sydude/ESP32-P4-Display-Development-Daughterboard/docs/design-notes/email response from displayman on 9-15-2026.md

Dear Sy,

Thank you for your detailed inquiry.

Regarding the MIPI lane rate question, if the calculated lane rate exceeds your specification limits, you can lower the frame rate to fit your host design.

A strict 60 FPS is not mandatory—the module supports a flexible frame rate range between 46 Hz and 60 Hz, as long as the screen displays properly.

Attached please find a screenshot of our reference LCD timing configuration code for your engineering team's review.

Please feel free to let us know if you need any further assistance.

Best Regards

Anson.ho
DISPLAYMAN (SZ) TECH CO., LTD
Mobile / WhatsApp: +86 189 4831 4091
Tel: +86 755 3317 7071
Website: displayman.com

[See image attached to email in separate repo file]
