sydude/ESP32-P4-Display-Development-Daughterboard/docs/references.md

# References

This index records source documents and manufacturer links used by the project. Manufacturer and third-party PDFs are not stored in this repository unless deliberately approved.

## User-supplied project sources

| ID | Manufacturer / source | Document | Revision / identity | Repository status |
|---|---|---|---|---|
| S1 | Displayman (SZ) Technology Co., Ltd. | `KD068HDFID009-C009A` module datasheet | v1.0, 2024-11-25, 40 pages; SHA-256 `4c8394ac…03bcf` | External source; not committed |
| S2 | Displayman | `KD068HDFID009 -2LANE.txt` initialization file | SHA-256 `81ec9ab8…e6872c` | External source; not committed |
| S3 | Waveshare | `ESP32-P4-NANO-schematic.pdf` | PDF created 2024-10-25; SHA-256 `1e57b31f…10de1` | Original manufacturer PDF committed under `hardware/mechanical/vendor/Waveshare/ESP32-P4-NANO/`; authoritative electrical cross-check |
| S7 | Displayman, Anson Ho | Email reporting Displayman engineering confirmation that S2, including `RSOX(600)`, is correct for exact module | Received 2026-09-13 | External correspondence; summarized in PRD v0.2 |
| S8 | Displayman, Anson Ho | Detailed engineering response covering IOVCC, sequence, DSI, backlight, mapping, FPCs, and GT9271 | Received 2026-09-14; SHA-256 `76a9e53303412ff29189debf72a1f4c5dcf495e249f0ce86e32092063407ed4d` | User deliberately committed [email-chain PDF](design-notes/Re-%20Displayman%20%7C%20Datasheet%20%26%20Evaluation%20Units%20for%20KD068HDFID009-C009A.pdf); analyzed in PRD v0.3 |
| S9 | Displayman, Anson Ho | Follow-up email and reference LCD timing screenshot | Received 2026-09-15; email SHA-256 `8823097df6d8f23fd516d2b6e0f963860ce33b882156e1e74eb6324d2f1189f4`; screenshot SHA-256 `0e07dbbabf7c044b3f3cbf885d786e36a1ac6d44cc7af4ac6fe7aa517a8977d3` | User deliberately committed [email text](design-notes/email%20response%20from%20displayman%20on%209-15-2026.md) and [timing screenshot](design-notes/email%20response%20from%20displayman%20on%209-15-2026%20%5BIMAGE%5D.jpg) in `e98d2188f5f2b2ff797b6d45c06f2300e67c91f1`; analyzed in PRD v0.5 |
| S10 | Waveshare | ESP32-P4-NANO Wiki GPIO/pinout chart, `ESP32-P4-NANO-details_inter.jpg` | SHA-256 `271259f8…b8f5d9` | Original manufacturer chart committed beside S3; primary source for physical P1/P2 pin positions and GPIO names |
| S11 | Waveshare | ESP32-P4-NANO board image, `esp32-p4-nano.jpg` | SHA-256 `33af2c47…25f76` | Original Wiki image committed for visual orientation/corroboration only; not a precision dimensional source |

Abbreviated hashes match `docs/PRD.md`. Full hashes should be retained in controlled project records if the source package is deliberately archived.

## Platform and board documentation

Checked through 2026-09-21.

| Manufacturer | Document | Revision / date | Source |
|---|---|---|---|
| Espressif Systems | ESP32-P4 Series Datasheet | v0.7, 2026-07-14 | [Manufacturer documentation](https://documentation.espressif.com/esp32-p4_datasheet_en.html) |
| Espressif Systems | ESP32-P4 Hardware Design Guidelines | v1.9, 2026-07-21 | [Manufacturer PDF](https://documentation.espressif.com/esp-hardware-design-guidelines/en/latest/esp32p4/esp-hardware-design-guidelines-en-master-esp32p4.pdf) |
| Espressif Systems | ESP-IDF MIPI DSI LCD API | Current online documentation | [Manufacturer documentation](https://docs.espressif.com/projects/esp-idf/en/stable/esp32p4/api-reference/peripherals/lcd/dsi_lcd.html) |
| Waveshare | ESP32-P4-NANO product documentation | Current online documentation; S10 controls physical header mapping, S3 is the electrical cross-check, and the original PDF/DXF/STEP control dimensions | [Manufacturer documentation](https://www.waveshare.com/wiki/ESP32-P4-NANO) |

## Display-module corroboration and evidence limits

Checked 2026-09-15. These public listings are secondary to the exact-module datasheet, initialization file, and direct Displayman correspondence. They support product identity/family plausibility only and do not establish a GC9703C HS lane-rate limit.

| Evidence class | Source | Supported observation | Explicit limitation |
|---|---|---|---|
| Manufacturer public listing | Displayman, KD068HDFID009-C009A | Exact module is listed as 480 × 1280, two-lane MIPI display, I²C touch, GT9271 | Does not publish D-PHY HS operating rate or controller maximum; [manufacturer page](https://displayman.com/bar-type-tft-lcd-displays/) |
| Third-party exact-family listing | Startek/TFT-TFT, KD068HDFID009 | Base module is listed as GC9703C, 480 × 1280, two-lane MIPI, 40-pin, 6S4P/19.2 V/240 mA | Not a substitute for exact C009A controlled documentation; [product page](https://en.tft-tft.com/product/1658-KD068HDFID009-6.8-inch-480x1280-2-Lane-MIPI-interface-GC9703C-Bar-Type-TFT-high-brightness-IPS-LCD-Module.html) |
| Third-party sibling-module listing | Startek/TFT-TFT, KD068HDFID020 | Closely related 480 × 1280 / 60.19 × 160.51 mm GC9703C platform is offered with 3/4-lane MIPI | Sibling evidence only; cannot prove C009A rate capability; [product page](https://www.tft-tft.com/product/detail?id=899) |

No authoritative independent GC9703C datasheet or manufacturer source substantiating the previously stated 500 Mb/s/lane maximum was located in this review. Accordingly, 500 Mb/s/lane is recorded as an unverified claim, not as a controller specification; absence of corroboration is not proof of a higher limit.

## Power, sequencing, and interface components

Checked through 2026-09-19. Status is the manufacturer product-page status where shown. `docs/PRD.md` remains controlling; the populated selections and calculations are recorded in `docs/design-notes/schematic-calculations.md`.

| Manufacturer | Part number / family | Function | Status / document | Source |
|---|---|---|---|---|
| Texas Instruments | `LM76003RNPR` | 24 V to 5 V buck | ACTIVE; datasheet Rev. A | [LM76003](https://www.ti.com/product/LM76003) |
| Texas Instruments | `TLV75533PDBVR`, `TLV75528PDBVR`, `TLV75518PDBVR` | Touch 3.3 V / VCI 2.8 V / IOVCC 1.8 V LDOs | ACTIVE/production; datasheet Rev. D | [TLV755P](https://www.ti.com/product/TLV755P) |
| Texas Instruments | `TPS22919DCKR` | VCI load switch | ACTIVE; datasheet Rev. B | [TPS22919](https://www.ti.com/product/TPS22919) |
| Texas Instruments | `LM3880MF-1AA/NOPB` | Three-stage display sequencer | ACTIVE/production; datasheet Rev. M; exact `-1AA` gives 1→2→3 startup and 3→2→1 shutdown with 10 ms nominal stages | [LM3880](https://www.ti.com/product/LM3880), [datasheet](https://www.ti.com/lit/ds/symlink/lm3880.pdf) |
| Texas Instruments | `TPS3808G01DBVR` | Power-fail supervisor | ACTIVE/production; datasheet Rev. N; pinout, ±2% adjustable threshold, SENSE current and 1–10 nF bypass recommendation audited | [TPS3808](https://www.ti.com/product/TPS3808), [datasheet](https://www.ti.com/lit/ds/symlink/tps3808.pdf) |
| Texas Instruments | `SN74LVC1G07DBVR` | Open-drain reset buffer with Ioff | ACTIVE; datasheet Rev. AG | [SN74LVC1G07](https://www.ti.com/product/SN74LVC1G07) |
| Texas Instruments | `SN74LVC1G11DCKR` | Three-input hardware backlight-enable gate | ACTIVE; partial-power-down/Ioff behavior | [SN74LVC1G11](https://www.ti.com/product/SN74LVC1G11) |
| Texas Instruments | `PCA9306DCTR` | Original I2C translator candidate | ACTIVE; superseded because it does not isolate INT/RESET | [PCA9306](https://www.ti.com/product/PCA9306) |
| Texas Instruments | `TMUX1574DYYR` / `TMUX1574PWR` | Recommended four-channel powered-off-protected touch switch | ACTIVE; datasheet Rev. C | [TMUX1574](https://www.ti.com/product/TMUX1574) |
| Texas Instruments | `TPD6E05U06RVZR` | Six-channel MIPI ESD | ACTIVE; TPDxE05U06 family | [TPD6E05U06](https://www.ti.com/product/TPD6E05U06) |
| Texas Instruments | `TPD4E05U06DQAR` | Four-channel touch ESD | ACTIVE; TPDxE05U06 family | [TPD4E05U06](https://www.ti.com/product/TPD4E05U06) |
| Texas Instruments | `TPS92511DDA` | Original buck backlight candidate | ACTIVE; superseded as baseline because full-temperature current spread is wider than project ±5% target | [TPS92511](https://www.ti.com/product/TPS92511) |
| Texas Instruments | `TPS922053DYYR` | Preferred 240 mA buck backlight driver | ACTIVE/production; datasheet Rev. B; 4.5–65 V, external 200 mV current sense, 100 ns minimum off-time, fast/hybrid PWM | [TPS922053](https://www.ti.com/product/TPS922053), [datasheet](https://www.ti.com/lit/ds/symlink/tps922053.pdf) |
| Vishay | `IHLP6767GZER680M11` | Selected 68 µH backlight inductor | IHLP-6767GZ-11 commercial low-DCR series; 6.1 A heat-rated and 4.5 A typical saturation current; manufacturer product page/datasheet checked 2026-09-16 | [Manufacturer product page](https://www.vishay.com/en/product/34282/) |
| Vishay | `SS2H10-E3/52T`, `SS34-E3/57T`, `BAT46W-E3-08` | Backlight catch diode, hold-up diode, and LM5176 bootstrap diodes | Current manufacturer families; 100 V bootstrap/catch selections preserve voltage margin | [SS2H10](https://www.vishay.com/en/product/88961/), [SS34](https://www.vishay.com/en/product/88751/), [BAT46W](https://www.vishay.com/en/product/85662/) |
| Murata | `BLM18KG601SN1D` | Backlight-anode EMI bead | 0603, 600 Ω at 100 MHz, 1 A class; headroom/temperature to be verified on prototype | [Manufacturer page](https://www.murata.com/en-us/products/productdetail?partno=BLM18KG601SN1%23) |
| KEMET | `C0603C823K3RACTU` | LM74800 82 nF/25 V/X7R HGATE dV/dt capacitor | Current 0603 X7R catalog part; selected in place of an obsolete Murata suffix found during the audit | [KEMET X7R SMD family datasheet](https://content.kemet.com/datasheets/KEM_C1002_X7R_SMD.pdf) |
| Panasonic | `ERJ-3EKF1002V` | LM74800 10 kΩ/1% HGATE series resistor | Current general-purpose 0603 precision thick-film part | [Manufacturer part page](https://industrial.panasonic.com/ww/products/pt/general-purpose-chip-resistors/models/ERJ3EKF1002V) |
| Murata | `GRM1885C1H102JA01D` | TPS3808 1 nF/50 V/C0G SENSE bypass | Current 0603 C0G catalog part | [Manufacturer product detail](https://pim.murata.com/en-us/pim/details/?partNum=GRM1885C1H102JA01D) |
| Analog Devices | `LT8391A` | Four-switch buck-boost LED contingency | Recommended for new designs; datasheet Rev. A; use only if completed buck headroom validation fails | [Product page](https://www.analog.com/en/products/lt8391a.html), [datasheet](https://www.analog.com/media/en/technical-documentation/data-sheets/lt8391a.pdf) |

## Nominal-12 V input, protection, and conversion components

Checked through 2026-09-16. Automotive/AEC qualification of individual parts does not qualify the assembled evaluation board to ISO 7637 or ISO 16750.

| Manufacturer | Part number / family | Function | Status / validation note | Source |
|---|---|---|---|---|
| Texas Instruments | `LM74800QDRRRQ1` / LM7480-Q1 | Vehicle reverse-polarity, reverse-current, inrush, and overvoltage control with back-to-back N-FETs | ACTIVE; AEC-Q100; 3–65 V, −65 V reverse input, WSON-12; datasheet Rev. C | [Product page](https://www.ti.com/product/LM7480-Q1), [datasheet](https://www.ti.com/lit/ds/symlink/lm7480-q1.pdf) |
| Texas Instruments | `LM5176QPWPRQ1` | 12 V vehicle to nominal-24 V four-switch synchronous buck-boost controller | ACTIVE; AEC-Q100; 4.2–55 V operating, 60 V maximum, HTSSOP-28; datasheet Rev. B | [Product page](https://www.ti.com/product/LM5176-Q1), [datasheet](https://www.ti.com/lit/ds/symlink/lm5176-q1.pdf) |
| Texas Instruments | `LM51772-Q1` | Newer four-switch comparison candidate | ACTIVE; 55 V, optional I²C, VQFN-40; not selected because its added complexity is unnecessary for a fixed 24 V rail | [Product page](https://www.ti.com/product/LM51772-Q1) |
| Texas Instruments | `CSD19531Q5A` | 100 V N-MOSFET for input protection and four-switch conversion | ACTIVE; 6.4 mΩ max at 10 V, 37 nC typical Qg, 5 × 6 mm SON; SOA checked for LM74800 ramp | [Product page](https://www.ti.com/product/CSD19531Q5A), [datasheet](https://www.ti.com/lit/ds/symlink/csd19531q5a.pdf) |
| Texas Instruments | `TPS259470ARPWR` / TPS25947 | Nano 5 V current limiting, inrush control, and true reverse-current blocking | ACTIVE; 2.7–23 V, 5.5 A, 28 mΩ typical; datasheet Rev. C, May 2026 | [Product page](https://www.ti.com/product/TPS25947), [datasheet](https://www.ti.com/lit/ds/symlink/tps25947.pdf) |
| Bourns | `SM8S24CA-Q` | Vehicle high-energy bidirectional TVS | Automotive/AEC-Q101 series; 24 V standoff, 38.9 V clamp class, 6.6 kW, DO-218; package and recommended land pattern used for project footprint | [Manufacturer datasheet/drawing](https://www.bourns.com/docs/product-datasheets/sm8s-q.pdf) |
| Coilcraft | `XAL7070-153MEC`, `XAL7070-103MEC` | Selected 15 µH LM5176 and 10 µH LM76003 inductors | Current shielded molded series; selected values and current ratings checked in the manufacturer table | [Manufacturer series page](https://www.coilcraft.com/en-us/products/power/shielded-inductors/molded-inductor/xal/xal7070/) |
| Bourns | `SRP1038A-2R2M` | Vehicle input-filter inductor | Shielded AEC-Q200 SRP1038A family; 2.2 µH, 8 A class; mechanical dimensions used for the local model | [Manufacturer product page](https://www.bourns.com/products/magnetic-products/power-inductors-smd-high-current-shielded/product/SRP1038A), [datasheet](https://www.bourns.com/docs/product-datasheets/srp1038a.pdf) |
| Molex | `43045-0218` / `43025-0200` | Selected keyed vehicle-evaluation connector pair | Micro-Fit 3.0, two circuits; vertical SMT board header with mating receptacle; not sealed/automotive-qualified; footprint checked against sales drawing | [Header](https://www.molex.com/en-us/products/part-detail/430450218), [housing](https://www.molex.com/en-us/products/part-detail/430250200), [drawing](https://www.molex.com/content/dam/molex/molex-dot-com/products/automated/en-us/salesdrawingpdf/430/43045/430450218_sd.pdf), [manufacturer STEP archive](https://www.molex.com/content/dam/molex/molex-dot-com/products/automated/en-us/3dcadmodels/430/43045/430450218_stp.zip) |
| Littelfuse / Keystone | `0297005.WXNV` / `3568` | Selected serviceable vehicle-branch fuse and PCB holder | 5 A MINI blade fuse in a through-hole PCB holder | [Littelfuse 297 series](https://www.littelfuse.com/products/fuses-overcurrent-protection/fuses/automotive-passenger-car/blade-fuses/297), [Keystone 3568](https://www.keyelco.com/product.cfm/product_id/14138) |

## Connectors and cables

Checked through 2026-09-21.

| Manufacturer | Part number | Function | Documented configuration | Source |
|---|---|---|---|---|
| Molex | `505110-4096` | Panel LCD connector | 40 position, 0.50 mm, bottom contact, front flip, 1.90 mm height; project footprint and official manufacturer STEP checked against sales drawing | [Manufacturer page](https://www.molex.com/en-us/products/part-detail/5051104096), [drawing](https://www.molex.com/content/dam/molex/molex-dot-com/products/automated/en-us/salesdrawingpdf/505/505110/5051104096_sd.pdf), [manufacturer STEP archive](https://www.molex.com/content/dam/molex/molex-dot-com/products/automated/en-us/3dcadmodels/505/505110/5051104096_stp.zip) |
| Molex | `0150200429` | Conditional panel LCD extension candidate | 40 circuit, 0.50 mm, type A same-side contacts, 76 mm; not a direct mate between J702 and a bare panel flex tail | [Manufacturer page](https://www.molex.com/en-us/products/part-detail/150200429) |
| Molex | `0150200431` | Conditional panel LCD extension candidate | 40 circuit, 0.50 mm, type A same-side contacts, 102 mm; not a direct mate between J702 and a bare panel flex tail | [Manufacturer page](https://www.molex.com/en-us/products/part-detail/150200431) |
| Amphenol Communications Solutions | `SFW15R-2STE1LF` | Nano DSI connector candidate | ACTIVE; 15 position, 1.00 mm, top contact, side-entry SMT ZIF; project footprint and official manufacturer STEP checked against drawing 10172241 Rev. A | [Manufacturer page](https://www.amphenol-cs.com/product/sfw15r2ste1lf.html), [drawing](https://cdn.amphenol-cs.com/media/wysiwyg/files/drawing/10172241.pdf), [manufacturer STEP archive](https://cdn.amphenol-cs.com/media/wysiwyg/files/3d/ssfw15r_2_4stlf.zip) |
| Hirose Electric | `FH12-8S-0.5SH(55)` | Touch connector candidate | 8 position, 0.50 mm, bottom contact, front ZIF, 2.0 mm height | [Manufacturer page](https://www.hirose.com/product/p/CL0586-0744-5-55) |
| Samtec | `SSQ-113-01-G-D` | Selected Nano P1/P2 stack sockets | 2 × 13, 2.54 mm pitch and row spacing, 8.51 mm body, 2.64 mm tails, 3.68–6.35 mm insertion range for 0.64 mm-square posts. Bottom-mounted on the daughterboard; nominal facing-PCB separation is 11.01 mm because USB-A/RJ45 are cleared by local cutouts. | [Exact product](https://www.samtec.com/products/ssq-113-01-g-d), [manufacturer SSQ drawing Rev. BH](https://suddendocs.samtec.com/prints/ssq-1xx-xx-xxx-x-xx-xxx-xx-x-mkt.pdf), [SSQ family](https://www.samtec.com/products/ssq) |
| Waveshare | ESP32-P4-NANO mechanical PDF/DXF/STEP dated 2026-03-31 | Nano outline, mounting holes, headers, component envelopes and stacking reference | Original files preserved under `hardware/mechanical/vendor/Waveshare/ESP32-P4-NANO/`; [manufacturer resources](https://docs.waveshare.com/ESP32-P4-NANO/Resources-And-Documents); validation in `docs/design-notes/mechanical-interface-verification.md` |

Manufacturer electrical and mechanical documents control the design. Distributor availability is a procurement snapshot and must be rechecked before schematic freeze, prototype purchasing, and assembly release.

## Package, footprint and model sources

Checked through 2026-09-20 for the final project-local footprint audit. These links supplement the component electrical sources above; manufacturer package drawings remain controlling. Project-local simplified models reproduce the verified mechanical envelope and board interface where an exact redistributable model was unavailable. Detailed dimensions, intentional land-pattern departures, corrections and physical-verification boundaries are recorded in `docs/design-notes/project-local-footprint-verification.md`.

| Manufacturer / source | Package or part | Use | Source |
|---|---|---|---|
| Texas Instruments | DRR0012E (4224874 C11), PWP0028V (4230409 A01), RNP0030B (4222784 B09), RPW0010A (4225183 A08) and DYY0014A (4224643 D07) | Project-local IC footprints/models independently checked against the current package and stencil drawings included in the selected-device datasheets | [TI package search](https://www.ti.com/packaging/docs/searchtipackages.tsp) and the selected-device datasheets linked above |
| Nichicon | `UHW1A682MHD` | Exact C601 selection; 6800 µF, 10 V, 16 mm × 25 mm body, 7.5 mm lead spacing | [Manufacturer UHW series page](https://www.nichicon.co.jp/english/products/aluminum_electrolytic_capacitors/uhw/) |
| KiCad | KiCad 10 standard footprint and 3D-model libraries | Standard passives, headers/sockets, touch FFC, fuse holder and common packages; four local copies retain standard land geometry while repairing absent model linkage | [Official KiCad libraries](https://gitlab.com/kicad/libraries) |

Official STEP files committed for Amphenol SFW15R-2STE1LF and Molex 505110-4096 were taken from the linked manufacturer archives. The Molex 43045-0218 model endpoint did not provide a usable archive during this pass, so the committed simplified Micro-Fit model follows the manufacturer sales drawing and verified footprint envelope; this limitation is recorded rather than presenting it as an official model.
