sydude/ESP32-P4-Display-Development-Daughterboard/docs/design-notes/email response from displayman on 9-15-2026 [IMAGE].jpg

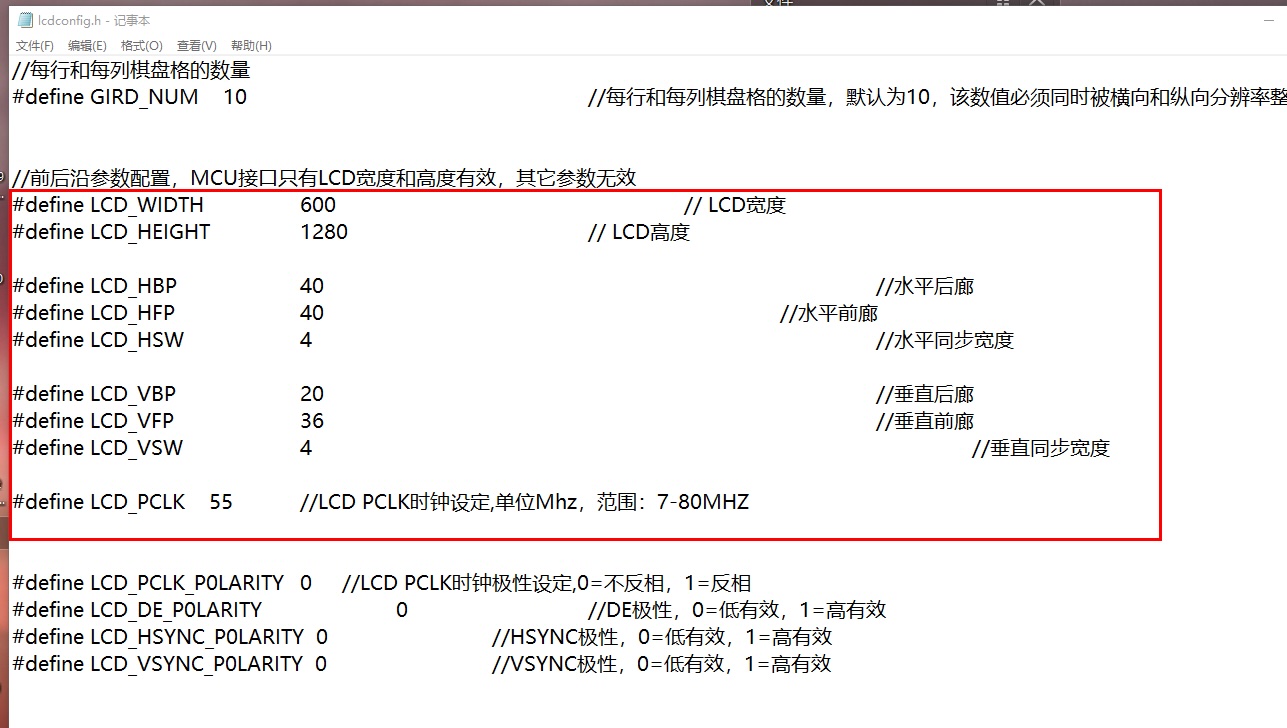
docs/design-notes/email response from displayman on 9-15-2026 [IMAGE].jpg
