sydude/ESP32-P4-Display-Development-Daughterboard/hardware/kicad/Board Outline.dxf

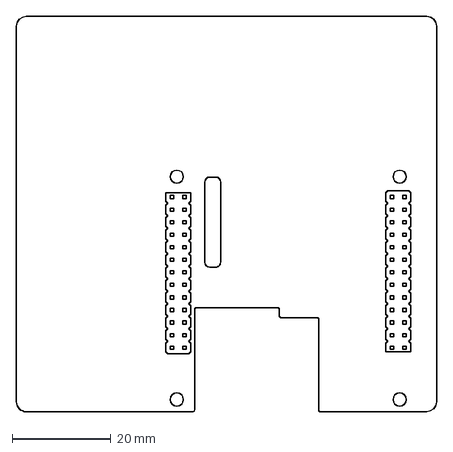
[picture p2: CAD file, 2026-09-22]
hardware/kicad/Board Outline.dxf
85.0 x 80.0 mm
