sydude/ESP32-P4-Display-Development-Daughterboard/hardware/kicad/ESP32-P4 Display Development Daughterboard.kicad_pcb

## KiCad design hardware/kicad/ESP32-P4 Display Development Daughterboard.kicad_pcb (2026-10-30)

Schematic: ESP32-P4 Display Development Daughterboard.kicad_sch, ESP32-P4 Displayman Development Daughterboard

Parts:
C201, C205, C206, C902: 100nF 100V; C_0603_1608Metric
C202: 22uF 50V X7R; C_1210_3225Metric
C203: 100uF 50V; CP_Elec_10x10
C204, C901, C908: 10uF 50V; C_1210_3225Metric
C207: 82nF 100V X7R; C_0603_1608Metric; MPN C0603C823K1RACAUTO
C301: 47pF C0G; C_0402_1005Metric
C302, C305: 270pF C0G; C_0603_1608Metric
C303, C307, C308, C803: 100nF; C_0603_1608Metric
C304: 82nF X7R; C_0603_1608Metric
C306: 1uF 16V; C_0603_1608Metric
C309, C311: 220uF 35V; CP_Elec_10x12.5
C310, C312, C313: 22uF 50V; C_1210_3225Metric
C501: 470nF; C_0603_1608Metric
C502: 2.2uF 10V; C_0603_1608Metric
C503, C513, C514, C603, C801, C903: 1uF 10V; C_0603_1608Metric
C504: 22nF; C_0603_1608Metric
C505, C506: 4.7uF 100V; C_1210_3225Metric
C507: 47nF 100V; C_0603_1608Metric
C508, C509, C510, C511: 22uF 10V; C_1210_3225Metric
C512: 10nF; C_0603_1608Metric
C601: 6800uF 10V; CP_Radial_D16.0mm_P7.50mm; MPN UHW1A682MHD
C602: 100pF C0G; C_0603_1608Metric
C604, C605: 2.2uF 6.3V; C_0603_1608Metric
C606, C802: 4.7uF 6.3V; C_0603_1608Metric
C607: 1nF 50V C0G; C_0603_1608Metric; MPN GRM1885C1H102JA01D
C904: 1nF 50V; C_0603_1608Metric
C905: 2.2uF 50V; C_1210_3225Metric
C906: 1nF; C_0603_1608Metric
C907: 1nF; C_0603_1608Metric; not fitted
D201: SM8S24CA-Q; Bourns_DO-218AB; MPN SM8S24CA-Q
D301, D302: BAT46W-E3-08; D_SOD-123; MPN BAT46W-E3-08
D601: SS34-E3/57T; D_SMA; MPN SS34-E3/57T
D602: 1N4148W; D_SOD-123
D901: SS2H10-E3/52T; D_SMA; MPN SS2H10-E3/52T
D1001, D1002: GREEN; LED_0603_1608Metric; MPN LTST-C191KGKT
F201: 5A TIME DELAY; Fuseholder_Blade_Mini_Keystone_3568; MPN 0297005.WXNV / 3568
FB901: 600R@100MHz 1A; L_0603_1608Metric; MPN BLM18KG601SN1D
J1: 5034802200; CON_5034802200_MOL
J2: 525592253; CON_525592253_MOL
J101: ESP32-P4-WIFI6-DB-P1; 1x20
J102: ESP32-P4-WIFI6-DB-P2; 1x20
J201: VEHICLE 12V; CONN_SD-43045-007_02_MOL; MPN 43045-0218
J501: SERVICE LINK 5V; SolderJumper-2_P1.3mm_Bridged_RoundedPad1.0x1.5mm
J702: DISPLAYMAN LCD 40P; Molex_CON_5051104096; MPN 505110-4096
J801: Wurth 8pin Top Contact FPC; Wurth_68710814022
J901: BL HARD DISABLE; PinHeader_1x02_P2.54mm_Vertical
L201: 2.2uH 8A; L_Bourns_SRP1038A_10.0x10.0mm; MPN SRP1038A-2R2M
L301: 15uH; L_Coilcraft_XAL7070-XXX; MPN XAL7070-153MEC
L501: 10uH; L_Coilcraft_XAL7070-XXX; MPN XAL7070-103MEC
L901: 68uH; L_Vishay_IHLP-6767; MPN IHLP6767GZER680M11
PWR101, PWR201, PWR301, PWR501, PWR601: PWR_FLAG
Q201, Q202, Q301, Q302, Q303, Q304: CSD19531Q5A; Texas_DQJ0008A_VSONP-8; MPN CSD19531Q5A
Q801: MMBT3904; SOT-23; MPN MMBT3904LT1G
R201: 1.0R 2W; R_2512_6332Metric
R202: 56.2k 1%; R_0603_1608Metric
R203: 10.0k 1%; R_0603_1608Metric
R204: 100k 1%; R_0603_1608Metric
R205: 6.49k 1%; R_0603_1608Metric
R206: 100R 1%; R_0603_1608Metric; MPN ERJ-3EKF1000V
R301: 20mR 1% 2W; R_2512_6332Metric
R302, R309: 100R; R_0402_1005Metric
R303: 27.4k 1%; R_0603_1608Metric
R304: 93.1k 1%; R_0603_1608Metric
R305: 15.0k 1%; R_0603_1608Metric
R306: 580k 1%; R_0603_1608Metric
R307: 20.0k 1%; R_0603_1608Metric
R308, R509, R510, R604, R606, R607, R608, R609, R908: 47k; R_0603_1608Metric
R501: 100k 0.1%; R_0603_1608Metric
R502: 24.9k 0.1%; R_0603_1608Metric
R503, R602: 1.00M 1%; R_0603_1608Metric
R504: 68.1k 1%; R_0603_1608Metric
R505: 549R 1%; R_0603_1608Metric; not fitted
R506: 1.05k 1%; R_0603_1608Metric
R507, R511, R512, R611, R801, R802, R804, R909, R1001, R1002, R1003, R1004: 100k; R_0603_1608Metric
R508: 26.7k; R_0603_1608Metric
R601: 3.3R 2W PULSE; R_2512_6332Metric
R603: 21.5k 1%; R_0603_1608Metric
R605, R610, R1006: 10k; R_0603_1608Metric
R701, R702, R703, R704, R705, R706: 0R 0201; R_0201_0603Metric
R803: 4.7k; R_0603_1608Metric
R901, R902: 1.65R 0.1%; R_1206_3216Metric
R903, R905: 100R; R_0603_1608Metric
R904: 83k 1%; R_0603_1608Metric
R906: 0R; R_0603_1608Metric
R907: 1.00M; R_0603_1608Metric; not fitted
R910: 0R LED CURRENT LINK; R_2512_6332Metric
R1005: 47k; R_0603_1608Metric; not fitted
R1007: 2.2k; R_0603_1608Metric
U201: LM74800QDRRRQ1; Texas_DRR0012E_WSON-12_3x3mm_P0.5mm_EP1.3x2.5mm; MPN LM74800QDRRRQ1
U301: LM5176QPWPRQ1; Texas_PWP0028V_TSSOP-28-1EP_4.4x9.7mm_P0.65mm_EP3.4x9.7mm_M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; MPN LM5176QPWPRQ1
U501: LM76003RNPR; Texas_RNP0030B_WQFN-30-1EP_4x6mm_P0.5mm_EP1.8x4.5mm_Thermal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; MPN LM76003RNPR
U502: TPS259470ARPWR; RPW0010A-MFG; MPN TPS259470ARPWR
U601: TPS3808G01DBVR; SOT-23-6; MPN TPS3808G01DBVR
U602: LM3880MF-1AA/NOPB; SOT-23-6; MPN LM3880MF-1AA/NOPB
U603: TLV75518PDBVR; SOT-23-5; MPN TLV75518PDBVR
U604: TLV75528PDBVR; SOT-23-5; MPN TLV75528PDBVR
U605: TPS22919DCKR; SOT-363_SC-70-6; MPN TPS22919DCKR
U606, U607, U608: SN74LVC1G07DBVR; SOT-23-5; MPN SN74LVC1G07DBVR
U701: TPD6E05U06RVZR; Texas_R-PUSON-N14; MPN TPD6E05U06RVZR
U801: TLV75533PDBVR; SOT-23-5; MPN TLV75533PDBVR
U802: TMUX1574PWR; TSSOP-16_4.4x5mm_P0.65mm; MPN TMUX1574PWR
U803: TPD4E05U06DQAR; USON-10_2.5x1.0mm_P0.5mm; MPN TPD4E05U06DQAR
U901: TPS922053DYYR; Texas_DYY0014A_TSOT-23-14; MPN TPS922053DYYR
U902: SN74LVC1G11DCKR; SOT-363_SC-70-6; MPN SN74LVC1G11DCKR

Connections:
BL_DIM: J901.2, R909.1, U901.6 (EN/PWM)
BL_FAULT_N: R908.1, U901.7 (FAULT_N)
BL_GATE_OK: J901.1, U902.4 (Y)
BL_PWM: J101.10 (GPIO23), R1003.1, U902.1 (A)
BL_SW: D901.2 (A), L901.1, U901.14 (SW)
BOOT1: C307.1, D301.1 (K), U301.26 (BOOT1)
BOOT2: C308.1, D302.1 (K), U301.20 (BOOT2)
BUCK_SHUNT_HI: Q302.1 (S), Q302.2 (S), Q302.3 (S), R301.1, R302.1
BUS_SENSE: C607.1, R602.2, R603.1, U601.5 (SENSE)
COMP_RC: C304.1, R305.2
CTP_INT: J801.6 (INT), R803.1, U802.11 (S3A), U803.4 (D2+)
CTP_INT_HOST: J101.15 (GPIO32), R1005.1, U802.9 (D3)
CTP_RESET_N: J801.7 (RST_N), R804.1, U802.14 (S4A), U803.5 (D2-)
CTP_RESET_N_HOST: J101.9 (GPIO22), R1004.1, U802.12 (D4)
CTP_SCL: J801.4 (SCL), U802.2 (S1A), U803.1 (D1+)
CTP_SDA: J801.5 (SDA), U802.5 (S2A), U803.2 (D1-)
DISP_HOLD_5V: C601.1, C603.1, PWR601.1, R601.2, R604.2, R607.2, R608.2, R609.2, U601.3 (MR_N), U601.6 (VDD), U602.1 (VCC), U603.1 (IN), U604.1 (IN)
DSI_CLK_N_SRC: J1.15, R705.1
DSI_CLK_P_SRC: J1.14, R706.1
DSI_D0_N_SRC: J1.21, R701.1
DSI_D0_P_SRC: J1.20, R702.1
DSI_D1_N_SRC: J1.18, R703.1
DSI_D1_P_SRC: J1.17, R704.1
EFUSE_DVDT: C512.1, U502.7 (DVDT)
EFUSE_EN: R511.2, R512.1, U502.1 (EN/UVLO)
EFUSE_ILM: R505.1, R506.1, U502.9 (ILM)
EFUSE_OV: R507.2, R508.1, U502.2 (OVLO)
GND: C201.2, C202.2, C203.2, C204.2, C206.2, C207.2, C302.2, C303.2, C304.2, C305.2, C306.2, C309.2, C310.2, C311.2, C312.2, C313.2, C502.2, C503.2, C504.2, C505.2, C506.2, C507.2, C508.2, C509.2, C510.2, C511.2, C512.2, C513.2, C514.2, C601.2, C602.2, C603.2, C604.2, C605.2, C606.2, C607.2, C801.2, C802.2, C803.2, C901.2, C902.2, C903.2, C906.2, C907.2, C908.2, D201.2 (A), J1.4, J1.7, J1.10, J1.13, J1.16, J1.19, J1.22, J101.3 (GND), J101.8 (GND), J101.13 (GND), J101.18 (GND), J102.3 (GND), J102.8 (GND), J102.13 (GND), J102.16 (SCL/GPIO8), J102.18 (GND), J201.2 (BATT-), J702.4 (GND), J702.7 (GND), J702.10 (GND), J702.13 (GND), J702.16 (GND), J702.17 (GND), J702.18 (GND), J702.19 (GND), J702.20 (GND), J702.21 (GND), J702.22 (GND), J702.25 (GND), J702.30 (GND), J801.1 (GND), J801.8 (GND), PWR101.1, Q304.1 (S), Q304.2 (S), Q304.3 (S), Q801.2 (E), R203.2, R205.2, R301.2, R303.2, R304.2, R307.2, R309.1, R502.2, R504.2, R505.2, R506.2, R508.2, R512.2, R603.2, R606.2, R611.2, R804.2, R904.2, R907.2, R909.2, R1001.2, R1002.2, R1003.2, R1004.2, R1005.2, R1006.2, R1007.2, U201.7 (GND), U301.5 (DITH), U301.10 (AGND), U301.22 (PGND), U301.29 (EP), U501.7 (NC_GND), U501.13 (AGND), U501.14 (AGND), U501.15 (AGND), U501.17 (SYNC/MODE), U501.19 (NC_GND), U501.23 (NC_GND), U501.24 (PGND), U501.25 (PGND), U501.26 (PGND), U501.27 (NC_GND), U501.28 (NC_GND), U501.29 (NC_GND), U501.30 (NC_GND), U501.31 (EP), U502.8 (GND), U601.2 (GND), U602.2 (GND), U603.2 (GND), U604.2 (GND), U605.2 (GND), U606.3 (GND), U607.3 (GND), U608.3 (GND), U701.5 (GND), U701.10 (GND), U801.2 (GND), U802.1 (SEL), U802.3 (S1B), U802.6 (S2B), U802.8 (GND), U802.10 (S3B), U802.13 (S4B), U803.3 (GND), U803.8 (GND), U901.1 (PGND), U901.2 (AGND), U901.8 (TEMP), U902.3 (GND)
HDRV1: Q301.4 (G), U301.27 (HDRV1)
HDRV2: Q303.4 (G), U301.19 (HDRV2)
HOLD_CHARGE: D601.1 (K), R601.1
HOST_3V3_DETECT: Q801.1 (B), R801.2
HOST_3V3_REF: J1.1, R801.1
HOST_5V: J101.2 (VSYS), J501.2
HOST_5V_EFUSED: C514.1, J501.1, U502.6 (OUT)
HOST_EFUSE_FLT: R509.1, U502.4 (FLT)
HOST_I2C_SCL: J1.3, U802.4 (D1)
HOST_I2C_SDA: J1.2, U802.7 (D2)
LCD_IOVCC: C604.1, J702.3 (IOVCC_1V8), R610.1, U603.5 (OUT), U606.5 (VCC), U607.5 (VCC), U608.5 (VCC)
LCD_PWR_EN: J101.6 (GPIO20), R605.1, R1001.1
LCD_RESET_CMD_N: J101.7 (GPIO21), R1002.1, U606.2 (A)
LCD_RESET_N: J702.5 (RESET_N), R610.2, R611.1, U606.4 (Y_OD), U607.4 (Y_OD), U608.4 (Y_OD)
LCD_VCI: C606.1, J702.2 (VCI_2V8), U605.5 (QOD), U605.6 (VOUT)
LCD_VCI_RAW: C605.1, U604.5 (OUT), U605.1 (VIN)
LDRV1: Q302.4 (G), U301.25 (LDRV1)
LDRV2: Q304.4 (G), U301.21 (LDRV2)
LED5_R: D1002.1 (K), R1007.1
LED24_R: D1001.1 (K), R1006.1
LED_A: C905.1, C908.1, FB901.2, J702.39 (LED+), J702.40 (LED+)
LED_K: C905.2, J702.31 (LED-), J702.32 (LED-), R906.1, R910.1
LED_K_RAW: R901.1, R902.1, R903.1, R910.2
LED_SENSE_N: C904.2, L901.2, R901.2, R902.2, U901.13 (CSN)
LM760_BOOT: C501.1, U501.6 (BOOT)
LM760_EN: R503.2, R504.1, U501.18 (EN)
LM760_FB: R501.2, R502.1, U501.12 (FB)
LM760_SS: C504.1, U501.11 (SS/TRK)
LM760_SW: C501.2, L501.1, U501.1 (SW), U501.2 (SW), U501.3 (SW), U501.4 (SW), U501.5 (SW)
LM760_VCC: C502.1, U501.8 (VCC)
LM5176_COMP: C305.1, R305.1, U301.9 (COMP)
LM5176_CS: C301.1, R302.2, U301.16 (CS)
LM5176_CSG: C301.2, R309.2, U301.15 (CSG)
LM5176_MODE: R304.1, U301.4 (MODE)
LM5176_RT: R303.1, U301.6 (RT/SYNC)
LM5176_SLOPE: C302.1, U301.7 (SLOPE)
LM5176_SS: C303.1, U301.8 (SS)
LM5176_VCC: C306.1, D301.2 (A), D302.2 (A), U301.23 (VCC)
MIPI_0N: J702.8 (MIPI_0N), R701.2, U701.14 (D1+)
MIPI_0P: J702.9 (MIPI_0P), R702.2, U701.13 (D1-)
MIPI_1N: J702.11 (MIPI_1N), R703.2, U701.12 (D2+)
MIPI_1P: J702.12 (MIPI_1P), R704.2, U701.11 (D2-)
MIPI_CLKN: J702.14 (MIPI_CLKN), R705.2, U701.9 (D3+)
MIPI_CLKP: J702.15 (MIPI_CLKP), R706.2, U701.8 (D3-)
unnamed: U301.13 (ISNS-), U301.14 (ISNS+)
SEQ_ENABLE: D602.2 (A), R605.2, R606.1, U602.3 (EN)
SEQ_FLAG1: R607.1, U602.6 (FLAG1), U603.3 (EN), U604.3 (EN)
SEQ_FLAG2: R608.1, U602.5 (FLAG2), U605.3 (ON)
SEQ_FLAG3: R609.1, U602.4 (FLAG3), U607.2 (A), U902.2 (B)
SW1: C307.2, L301.1, Q301.1 (S), Q301.2 (S), Q301.3 (S), Q302.5 (D), Q302.6 (D), Q302.7 (D), Q302.8 (D), U301.28 (SW1)
SW2: C308.2, L301.2, Q303.1 (S), Q303.2 (S), Q303.3 (S), Q304.5 (D), Q304.6 (D), Q304.7 (D), Q304.8 (D), U301.18 (SW2)
SYS5_PGOOD: R510.1, U501.16 (PGOOD)
SYS24_PGOOD: R308.1, U301.17 (PGOOD)
SYS_5V_3A: C503.1, C508.1, C509.1, C510.1, C511.1, C513.1, C801.1, D601.2 (A), D1002.2 (A), L501.2, PWR501.1, R308.2, R501.1, R507.1, R509.2, R510.2, R511.1, U501.9 (BIAS), U502.5 (IN), U801.1 (IN)
SYS_24V: C311.1, C312.1, C313.1, C505.1, C506.1, C507.1, C901.1, C902.1, D901.1 (K), D1001.2 (A), FB901.1, PWR301.1, Q303.5 (D), Q303.6 (D), Q303.7 (D), Q303.8 (D), R306.1, R503.1, R602.1, U301.12 (VOSNS), U301.24 (BIAS), U501.20 (PVIN), U501.21 (PVIN), U501.22 (PVIN), U901.3 (VIN)
TMUX_EN_N: Q801.3 (C), R802.1, U802.15 (EN_N)
TOUCH_3V3: C802.1, C803.1, J801.3 (VDD_3V3), R802.2, R803.2, U801.5 (OUT), U802.16 (VDD), U902.6 (VCC)
TPS922_COMP: C906.1, R905.1, U901.10 (COMP)
TPS922_COMP_C: C907.1, R905.2
TPS922_CSP: C904.1, R903.2, U901.12 (CSP)
TPS922_FSET: R904.1, U901.9 (FSET)
TPS922_UVP: R906.2, R907.1, U901.11 (UVP)
TPS922_VCC: C903.1, R908.2, U901.4 (VCC), U901.5 (ADIM/HD)
TPS3808_CT: C602.1, U601.4 (CT)
VEH_12V_RAW: F201.1, J201.1 (BATT+)
VEH_CAP: C205.1, U201.11 (CAP)
VEH_DAMP: C204.1, R201.2
VEH_DGATE: Q201.4 (G), U201.1 (DGATE)
VEH_FB: R306.2, R307.1, U301.11 (FB)
VEH_FET_MID: C205.2, C206.1, Q201.5 (D), Q201.6 (D), Q201.7 (D), Q201.8 (D), Q202.5 (D), Q202.6 (D), Q202.7 (D), Q202.8 (D), U201.10 (VS), U201.12 (C)
VEH_FILTER: C201.1, C202.1, D201.1 (K), L201.2, Q201.1 (S), Q201.2 (S), Q201.3 (S), R201.1, R202.1, U201.2 (A), U201.3 (VSNS)
VEH_FUSED: F201.2, L201.1
VEH_HGATE: Q202.4 (G), R206.1, U201.8 (HGATE)
VEH_HGATE_DVDT: C207.1, R206.2
VEH_OV: R204.2, R205.1, U201.5 (OV)
VEH_OV_TOP: R204.1, U201.4 (SW)
VEH_PROT: C203.1, C309.1, C310.1, PWR201.1, Q202.1 (S), Q202.2 (S), Q202.3 (S), Q301.5 (D), Q301.6 (D), Q301.7 (D), Q301.8 (D), U201.9 (OUT), U301.1 (EN/UVLO), U301.2 (VIN), U301.3 (VISNS)
VEH_UVLO: R202.2, R203.1, U201.6 (EN/UVLO)
VIN_GOOD: D602.1 (K), R604.1, U601.1 (RESET_N), U608.2 (A), U801.3 (EN), U902.5 (C)

Notes on the sheet:
Target: 24.0 V, 30 W continuous, 300 kHz. RFB 580k/20k gives 24.0 V nominal.
01: SINGLE 12 V INPUT
02: VEHICLE INPUT PROTECTION
SYSTEM 24 V DISTRIBUTION (DEPRECATED)
LM76003: 500 kHz, 10 uH; checked over the regulated SYS_24V range. 4x22 uF output bank.
06: DISPLAY RAILS AND SEQUENCING
OV divider 100k/6.49k: 20.18 V nominal cutoff; rejects accidental 24 V vehicle-port connection.
83k FSET selects 300 kHz. 68 uH is validated over the regulated SYS_24V range; see calculations.
09: 240 MA BACKLIGHT
6800 uF is isolated from Host/backlight. At 0.20 A for 30 ms, droop is 0.88 V; sequencing remains above LDO dropout.
F101/TVS coordination and adapter inrush are prototype verification items; no automotive qualification claim.
UVLO divider 56.2k/10.0k: 8.15 V rising, about 7.49 V falling using LM7480 thresholds.
03: LM5176 SINGLE-SOURCE BUCK-BOOST
P1 pins 2/4 are Host 5 V. GPIO21/P1-13 is an unconnected documented alternate. GPIO24 remains untouched for USB Serial/JTAG.
At 8 V/30 W/85%, Iavg=4.41 A. With 15 uH, ripple is about 1.19 App and peak about 5.00 A.
05: SYSTEM 5 V AND HOST FEED
TMUX1574 SEL=0 uses the A paths; all B paths are grounded per datasheet. EN_N is pulled high when Host 3.3 V is absent.
Two 1.65 ohm/0.1% resistors in parallel give 0.825 ohm: 242.4 mA nominal; +3% threshold gives 249.9 mA.
07: MIPI DSI AND LCD CONNECTOR
100k/24.9k feedback gives 5.016 V nominal. 22 nF SS gives approximately 11 ms ramp.
TPS3808 threshold: 0.405*(1M+21.5k)/21.5k = 19.23 V nominal. Its reset directly clamps sequence/reset/backlight validity.
LM5176 output directly supplies SYS_24V; no high-voltage source ORing is present.
Host I2C already has 2.2k pull-ups; no additional Host-side pull-ups. Touch INT has the vendor-required 4.7k pull-up.
08: GT9271 TOUCH INTERFACE
Bench development uses a regulated/current-limited nominal 12 V supply at J201.
R701–R706 are inline zero-ohm 0201 tuning locations; layout them as minimal-discontinuity pass-through pads.
Straight-through lane identity and polarity. No AC coupling, common-mode choke, probe pad, or branch.
Corrected P1 controls: pin 7 GPIO23 BL PWM; 13 GPIO20 LCD power; 15 GPIO21 LCD reset; 16 GPIO22 touch reset; 23 GPIO32 touch INT.
10: HOST HEADERS AND DEBUG
SYS_24V has 264 uF converter output capacitance plus 19.547 uF distributed local bypass.

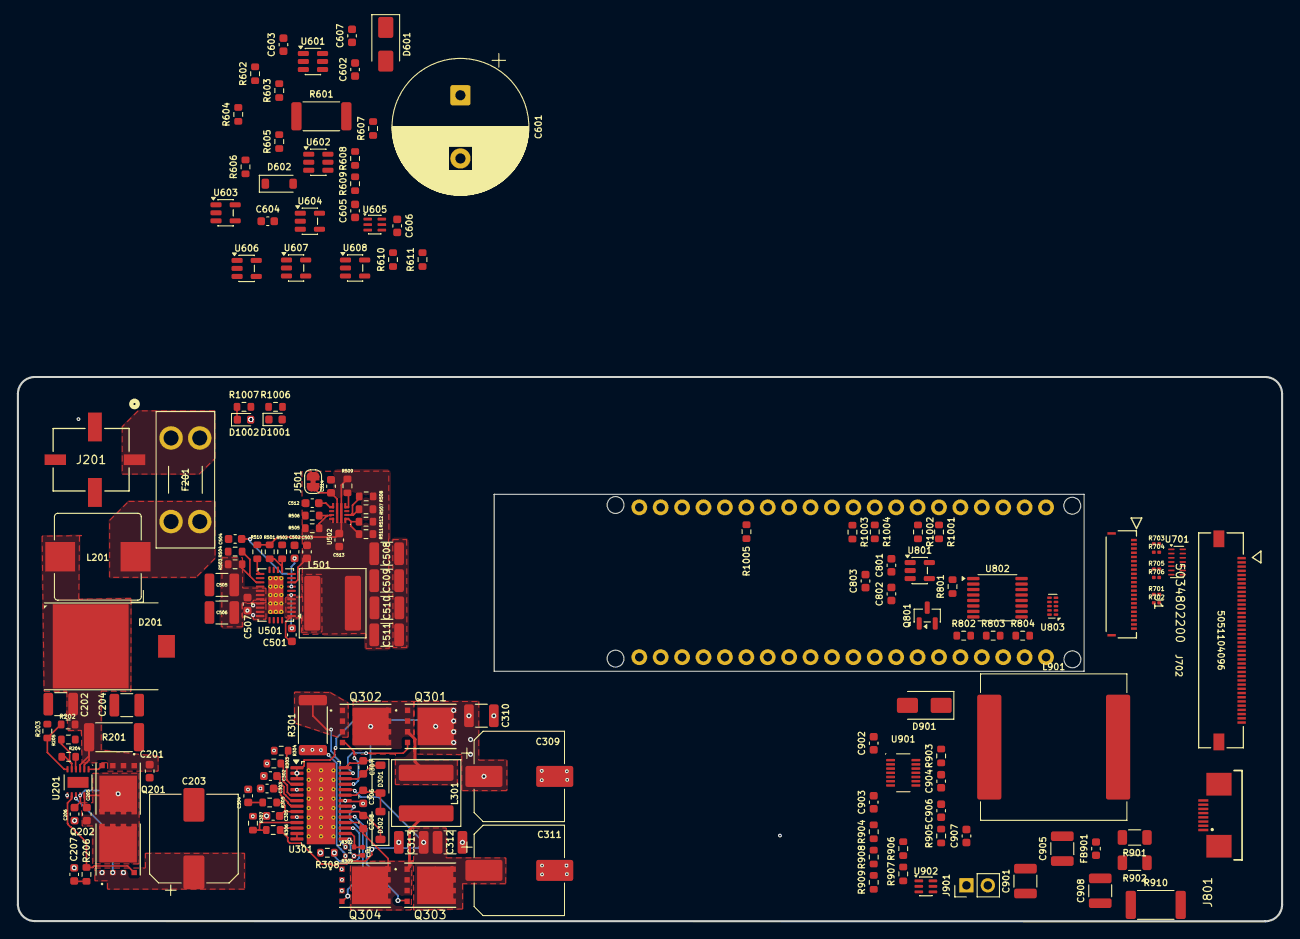
[picture p3: board ESP32-P4 Display Development Daughterboard.kicad_pcb from above]

Board: 4 copper layers, 150.0 x 64.6 mm, 164 parts (0 on the bottom side), 107 nets.
