sydude/ESP32-P4-Display-Development-Daughterboard/(commit log)

2026-09-13 moved kicad files to it's own folder
    [ESP32-P4 Display Development Daughterboard.kicad_pcb, ESP32-P4 Display Development Daughterboard.kicad_sch]
2026-09-13 create repo structure and organize accordingly
    [ESP32-P4 Display Development Daughterboard.kicad_pcb, ESP32-P4 Display Development Daughterboard.kicad_sch]
2026-09-14 docs: add vehicle-power evaluation architecture
2026-09-16 hardware: complete Phase 2 schematic capture
    [01_bench_input.kicad_sch, 02_vehicle_protection.kicad_sch, 03_vehicle_buckboost.kicad_sch, 04_source_oring.kicad_sch, 05_system_5v.kicad_sch, 06_display_power_sequence.kicad_sch, 07_mipi_panel.kicad_sch, 08_touch.kicad_sch]
2026-09-16 kicad updated files to newest version of kicad. Also increased text size on main sch sheet
    [01_bench_input.kicad_sch, 02_vehicle_protection.kicad_sch, 03_vehicle_buckboost.kicad_sch, 04_source_oring.kicad_sch, 05_system_5v.kicad_sch, 06_display_power_sequence.kicad_sch, 07_mipi_panel.kicad_sch, 08_touch.kicad_sch]
2026-09-17 hardware: complete schematic maintainability and libraries
    [01_power.kicad_sch, 02_display_power_backlight.kicad_sch, 03_interfaces_nano.kicad_sch, BOM.csv, ESP32-P4 Display Development Daughterboard.kicad_sch]
2026-09-17 archived deprecated schematic sheets and documented it
    moved deprecated excess schematic sheets to new archive folders and documented same in readme's
    [01_bench_input.kicad_sch, 02_vehicle_protection.kicad_sch, 03_vehicle_buckboost.kicad_sch, 04_source_oring.kicad_sch, 05_system_5v.kicad_sch, 06_display_power_sequence.kicad_sch, 07_mipi_panel.kicad_sch, 08_touch.kicad_sch]
2026-09-17 Delete LEGACY_GENERATED_SHEETS.md
    moved it's contents into the readme file at kicad/hardware/archive/legacy-generated-sheets
2026-09-17 created new drawing sheet with bigger title block size and added licensing terms into title block fields
    [01_power.kicad_sch, 02_display_power_backlight.kicad_sch, 03_interfaces_nano.kicad_sch, ESP32-P4 Display Development Daughterboard.kicad_sch]
2026-09-17 hardware: clean schematic label and field formatting
    [01_power.kicad_sch, 02_display_power_backlight.kicad_sch, 03_interfaces_nano.kicad_sch]
2026-09-17 chore: capture unexpected local KiCad schematic changes
    [02_display_power_backlight.kicad_sch, 03_interfaces_nano.kicad_sch]
2026-09-17 hardware: correct audited power startup and schematic geometry
    [01_power.kicad_sch, 02_display_power_backlight.kicad_sch, 03_interfaces_nano.kicad_sch, BOM.csv, ESP32-P4 Display Development Daughterboard.kicad_sch]
2026-09-19 Simplify power architecture to single 12V input
    [01_power.kicad_sch, 02_display_power_backlight.kicad_sch, 03_interfaces_nano.kicad_sch, BOM.csv, ESP32-P4 Display Development Daughterboard.kicad_sch]
2026-09-20 Complete project-local footprint verification
2026-09-20 inserted Nano board technical drawings onto PCB
    edited, scaled, pasted & locked official Nano drawings onto PCB board on User 1 custom layer.
    [ESP32-P4 Display Development Daughterboard.kicad_pcb]
2026-09-20 updated the background tech drawings and added annotations
    [ESP32-P4 Display Development Daughterboard.kicad_pcb]
2026-09-21 Added official Waveshare ESP32-P4-NANO board schematic
2026-09-21 added official Nano GPIO pinout and functions chart and also a board picture
2026-09-21 Correct Nano interface and document floorplan study
    [03_interfaces_nano.kicad_sch, BOM.csv]
2026-09-22 added board outline with cutouts for ethernet usb and DSI passthrough
    Inserted positioned and locked into the Edge Cuts layer approximately matching the Nano drawing on the User 1 layer.
    [Board Outline.dxf, ESP32-P4 Display Development Daughterboard.kicad_pcb]
2026-09-22 update board outline to include header locations
    [Board Outline.dxf, ESP32-P4 Display Development Daughterboard.kicad_pcb]
2026-09-22 fixed board outline layers so headers aren't part of edge cuts
    [ESP32-P4 Display Development Daughterboard.kicad_pcb]
2026-09-22 Validate SSQ stack and add preliminary PCB placement
    [03_interfaces_nano.kicad_sch, BOM.csv, ESP32-P4 Display Development Daughterboard.kicad_pcb]
2026-09-23 Correct J1001 no-connect markers
    [03_interfaces_nano.kicad_sch]
2026-09-23 Replace preliminary floorplan with routing-ready placement
    [ESP32-P4 Display Development Daughterboard.kicad_pcb]
2026-09-24 Repair PCB footprint links and refresh U301 footprint
    [01_power.kicad_sch, 02_display_power_backlight.kicad_sch, 03_interfaces_nano.kicad_sch, ESP32-P4 Display Development Daughterboard.kicad_pcb]
2026-09-25 Major fixes. Needs simplification, component organization and routing
    [02_display_power_backlight.kicad_sch, 03_interfaces_nano.kicad_sch, ESP32-P4 Display Development Daughterboard.kicad_pcb, ESP32-P4 Display Development Daughterboard.kicad_sch, ESP32-P4 Display FLUX.kicad_pcb, ESP32-P4 Display FLUX.kicad_sch]
2026-09-26 Removed kicad flux branch
    [ESP32-P4 Display FLUX.kicad_pcb, ESP32-P4 Display FLUX.kicad_sch]
2026-09-27 design update
    [ESP32-P4 Display Development Daughterboard.kicad_pcb, ESP32-P4 Display Development Daughterboard.kicad_sch]
2026-09-29 v0.5-nano-baseline (nano-final)
    This is the final baseline version of the project to use the Waveshare ESP32-P4-Nano host board. The project will be transitioning to the Waveshare ESP32-P4-WIFI6-DB host board going forward, and no will no longer use the Nano.
    [ESP32-P4 Display Development Daughterboard.kicad_pcb]
