sydude/ESP32-P4-Display-Development-Daughterboard/(notices)

Notices in the files:
hardware/kicad/01_power.kicad_sch:
© 2026 Sy Aryeh
Hardware license: see LICENSE.md
